DDeGonge/MiniBot/README.md

# MiniBot
Super cheap super tiny bots for....well I don't know yet
