DDeGonge/MiniBot/pcbs/MiniBot_MainBoard/MiniBot.kicad_pcb

## KiCad design pcbs/MiniBot_MainBoard/MiniBot.kicad_pcb (2026-08-21)

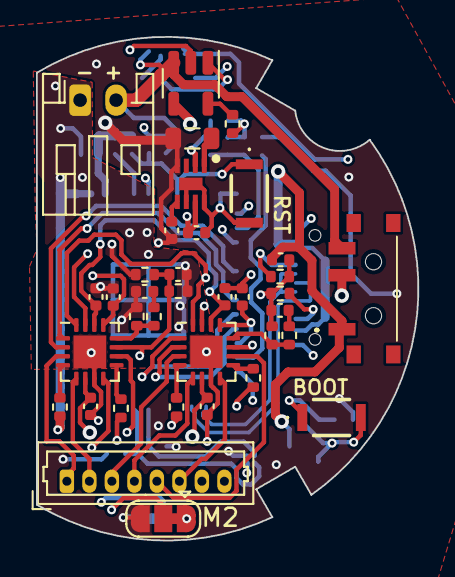
[picture p1: board pcbs/MiniBot_MainBoard/MiniBot.kicad_pcb from above]

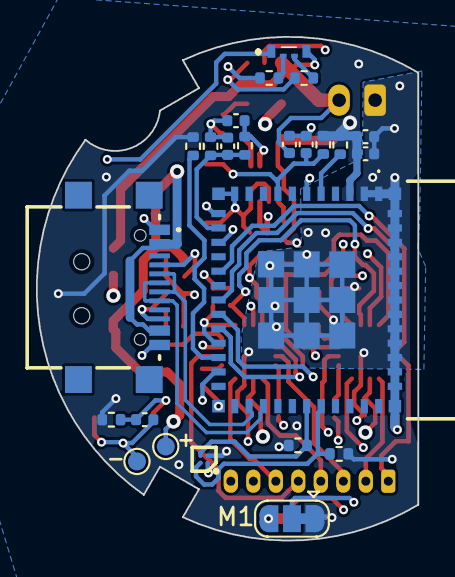
[picture p2: board pcbs/MiniBot_MainBoard/MiniBot.kicad_pcb from below]

Board: 4 copper layers, 21.2 x 28.0 mm, 60 parts (24 on the bottom side), 48 nets.

Parts:
C1, C8, C10: 4.7uF; C_0402_1005Metric
C2, C4, C5, C6, C9, C15, C16, C19, C20, C23: 0.1uF; C_0402_1005Metric
C3: 1uF; C_0402_1005Metric
C7: 560pF; C_0402_1005Metric
C17, C21: 10uF; C_0402_1005Metric
C18, C22: 22nF; C_0402_1005Metric
IC1: MMC5633NJL; BGA4C40P2X2_85X85X60
IC2: MIC23050-SYML-TR; SON50P200X200X90-9N-D
J1: Conn_01x08; Molex_PicoBlade_53047-0810_1x08_P1.25mm_Vertical
J2: Conn_01x02; JST_PH_S2B-PH-K_1x02_P2.00mm_Horizontal
J3: GSB1C41110SSHR
JP1, JP2: Jumper_3_Bridged12; SolderJumper-3_P1.3mm_Bridged12_RoundedPad1.0x1.5mm
L1: L; L_0805_2012Metric
LED1: EASV2010RWA0
R1, R2, R14, R15: 5.1k; R_0402_1005Metric
R3, R4, R5, R6, R9, R12: 10k; R_0402_1005Metric
R7, R10, R11: 390k; R_0402_1005Metric
R8: 12.4k; R_0402_1005Metric
R13, R16, R20: 1k; R_0402_1005Metric
R18, R19, R22, R23: 1; R_0402_1005Metric
R24, R25: 47k; R_0402_1005Metric
S1: PCM12SMTR
S2, S3: EVP-AWBD4A; EVPAWBD4A
TP1, TP2: TestPoint; TestPoint_Pad_D1.0mm
U1: ESP32-C3-MINI-1-H4X; ESP32C3MINI1H4X
U3: MCP73832-2-OT; SOT-23-5
U4, U5: STSPIN220; VQFN-16-1EP_3x3mm_P0.5mm_EP1.8x1.8mm

Connections:
+3V3: C1.2, C2.1, C7.1, IC1.B1 (VDD), IC2.4 (SNS), JP1.3 (B), JP2.1 (A), L1.1, R1.1, R2.1, R3.1, R5.1, R6.1, R7.1, R9.1, U1.3 (3V3)
+5V: C9.1, J3.A4 (VBUS_1), J3.A9 (VBUS_2), S1.1 (NC), TP2.1, U3.4 (V_{DD})
+BATT: C10.1, J2.2, LED1.4 (R6+), S1.3 (NO), U3.3 (V_{BAT})
/CC1: J3.A5 (CC1), R14.1
/CC2: J3.B5 (CC2), R15.1
/CFF: C7.2, IC2.5 (CFF)
/GPIO2: R6.2, U1.5 (IO2)
/GPIO8: R5.2, U1.22 (IO8)
/GPIO9: C5.1, R9.2, S3.A1 (NO), U1.23 (IO9)
/LED_R: LED1.3 (R6-), R13.1
/LED_W: LED1.1 (T1+), U1.12 (IO0)
/M0_A1: J1.1, U4.3 (OUTA1)
/M0_A2: J1.2, U4.5 (OUTA2)
/M0_B1: J1.8, U4.10 (OUTB1)
/M0_B2: J1.7, U4.8 (OUTB2)
/M0_DIR: U1.18 (IO4), U4.1 (DIR)
/M0_STEP: U1.16 (IO10), U4.2 (STCK)
/M1_A1: J1.3, U5.3 (OUTA1)
/M1_A2: J1.4, U5.5 (OUTA2)
/M1_B1: J1.5, U5.10 (OUTB1)
/M1_B2: J1.6, U5.8 (OUTB2)
/M1_DIR: U1.19 (IO5), U5.1 (DIR)
/M1_STEP: U1.20 (IO6), U5.2 (STCK)
/MODE1: JP2.2 (C), U4.16 (MODE1), U5.16 (MODE1)
/MODE2: JP1.2 (C), U4.15 (MODE2), U5.15 (MODE2)
/M_EN: C15.1, C19.1, U1.21 (IO7), U4.13 (EN/FLT), U5.13 (EN/FLT)
/M_RST: C16.1, C20.1, U1.6 (IO3), U4.14 (STBY/RESET), U5.14 (STBY/RESET)
/RST: C3.1, R3.2, S2.A1 (NO), U1.8 (EN)
/SCL: IC1.A2 (SCL), R1.2, U1.31 (TXD0)
/SDA: IC1.B2 (SDA), R2.2, U1.30 (RXD0)
/USB+: J3.A6 (DP1), J3.B6 (DP2), U1.27 (IO19)
/USB-: J3.A7 (DN1), J3.B7 (DN2), U1.26 (IO18)
/VREF: C4.1, R7.2, R8.1, U4.11 (REF), U5.11 (REF)
/VSENSE: C6.1, R10.2, R11.1, U1.13 (IO1)
GND: C1.1, C2.2, C3.2, C4.2, C5.2, C6.2, C8.2, C9.2, C10.2, C15.2, C16.2, C17.2, C18.2, C19.2, C20.2, C21.2, C22.2, C23.2, IC1.A1 (VSA), IC2.6 (AGND), IC2.8 (PGND), IC2.9 (EP), J2.1, J3.A1 (GND_1), J3.A12 (GND_2), JP1.1 (A), JP2.3 (B), R4.2, R8.2, R11.2, R12.2, R14.2, R15.2, R18.2, R19.2, R22.2, R23.2, R24.2, R25.2, S2.A2 (COM), S3.A2 (COM), TP1.1, U1.1 (GND_1), U1.2 (GND_2), U1.11 (GND_3), U1.14 (GND_4), U1.36 (GND_5), U1.37 (GND_6), U1.38 (GND_7), U1.39 (GND_8), U1.40 (GND_9), U1.41 (GND_10), U1.42 (GND_11), U1.43 (GND_12), U1.44 (GND_13), U1.45 (GND_14), U1.46 (GND_15), U1.47 (GND_16), U1.48 (GND_17), U1.49 (GND_18), U1.50 (GND_19), U1.51 (GND_20), U1.52 (GND_21), U1.53 (GND_22), U1.54 (GND_23), U1.55 (GND_24), U1.56 (GND_25), U1.57 (GND_26), U1.58 (GND_27), U1.59 (GND_28), U1.60 (GND_29), U1.61 (GND_30), U3.2 (V_{SS}), U4.7 (GND), U4.17 (EPAD), U5.7 (GND), U5.17 (EPAD)
unnamed: C18.1, R16.2
unnamed: C22.1, R20.2
unnamed: IC2.1 (SW), L1.2
unnamed: LED1.2 (T1-), R4.1
unnamed: R12.1, U3.5 (PROG)
unnamed: R13.2, U3.1 (STAT)
unnamed: R19.1, U4.4 (SENSEA)
unnamed: R18.1, U4.9 (SENSEB)
unnamed: R16.1, R24.1, U4.12 (TOFF)
unnamed: R23.1, U5.4 (SENSEA)
unnamed: R22.1, U5.9 (SENSEB)
unnamed: R20.1, R25.1, U5.12 (TOFF)
VDC: C8.1, C17.1, C21.1, C23.1, IC2.2 (EN), IC2.7 (VIN), R10.1, S1.2 (COM), U4.6 (VS), U5.6 (VS)
