DDeGonge/MiniBot/pcbs/Charge_Case/Charge_Case.kicad_pcb

## KiCad design pcbs/Charge_Case/Charge_Case.kicad_pcb (2026-07-29)

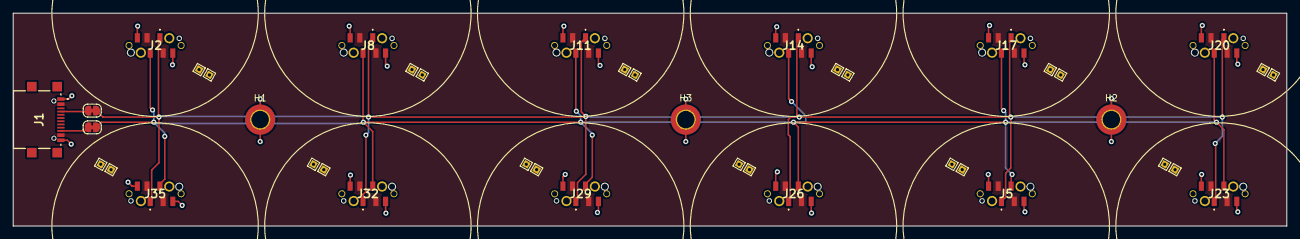
[picture p3: board Charge_Case.kicad_pcb from above]

Board: 2 copper layers, 197.5 x 33.0 mm, 42 parts (0 on the bottom side), 8 nets.

Parts:
H1, H2, H3: MountingHole_Pad; MountingHole_2.7mm_M2.5_DIN965_Pad_TopOnly
J1: GSB1C41110SSHR
J2, J5, J8, J11, J14, J17, J20, J23, J26, J29, J32, J35: USB4180-03-0120-C; USB4180030120C
J3, J4, J6, J7, J9, J10, J12, J13, J15, J16, J18, J19, J21, J22, J24, J25, J27, J28, J30, J31, J33, J34, J36, J37: Conn_01x01; TestPoint_THTPad_1.0x1.0mm_Drill0.5mm
JP1, JP2: Jumper_2_Bridged; SolderJumper-2_P1.3mm_Bridged_RoundedPad1.0x1.5mm

Connections:
+5V: J1.A4 (VBUS_1), J1.A9 (VBUS_2), J2.A9 (VBUS_1), J2.B9 (VBUS_2), J3.1, J5.A9 (VBUS_1), J5.B9 (VBUS_2), J6.1, J8.A9 (VBUS_1), J8.B9 (VBUS_2), J9.1, J11.A9 (VBUS_1), J11.B9 (VBUS_2), J12.1, J14.A9 (VBUS_1), J14.B9 (VBUS_2), J15.1, J17.A9 (VBUS_1), J17.B9 (VBUS_2), J18.1, J20.A9 (VBUS_1), J20.B9 (VBUS_2), J21.1, J23.A9 (VBUS_1), J23.B9 (VBUS_2), J24.1, J26.A9 (VBUS_1), J26.B9 (VBUS_2), J27.1, J29.A9 (VBUS_1), J29.B9 (VBUS_2), J30.1, J32.A9 (VBUS_1), J32.B9 (VBUS_2), J33.1, J35.A9 (VBUS_1), J35.B9 (VBUS_2), J36.1
/CC1: J2.A5 (CC1), J5.A5 (CC1), J8.A5 (CC1), J11.A5 (CC1), J14.A5 (CC1), J17.A5 (CC1), J20.A5 (CC1), J23.A5 (CC1), J26.A5 (CC1), J29.A5 (CC1), J32.A5 (CC1), J35.A5 (CC1), JP1.1 (A)
/CC1_SRC: J1.A5 (CC1), JP1.2 (B)
/CC2: J2.B5 (CC2), J5.B5 (CC2), J8.B5 (CC2), J11.B5 (CC2), J14.B5 (CC2), J17.B5 (CC2), J20.B5 (CC2), J23.B5 (CC2), J26.B5 (CC2), J29.B5 (CC2), J32.B5 (CC2), J35.B5 (CC2), JP2.1 (A)
/CC2_SRC: J1.B5 (CC2), JP2.2 (B)
GND: H1.1, H2.1, H3.1, J1.A1 (GND_1), J1.A12 (GND_2), J2.A12 (GND_1), J2.B12 (GND_2), J4.1, J5.A12 (GND_1), J5.B12 (GND_2), J7.1, J8.A12 (GND_1), J8.B12 (GND_2), J10.1, J11.A12 (GND_1), J11.B12 (GND_2), J13.1, J14.A12 (GND_1), J14.B12 (GND_2), J16.1, J17.A12 (GND_1), J17.B12 (GND_2), J19.1, J20.A12 (GND_1), J20.B12 (GND_2), J22.1, J23.A12 (GND_1), J23.B12 (GND_2), J25.1, J26.A12 (GND_1), J26.B12 (GND_2), J28.1, J29.A12 (GND_1), J29.B12 (GND_2), J31.1, J32.A12 (GND_1), J32.B12 (GND_2), J34.1, J35.A12 (GND_1), J35.B12 (GND_2), J37.1
unnamed: J1.A6 (DP1), J1.A7 (DN1)
unnamed: J1.B6 (DP2), J1.B7 (DN2)
