DDeGonge/MiniBot/pcb/MiniBot.kicad_pcb

## KiCad design pcb/MiniBot.kicad_pcb (2025-02-13)

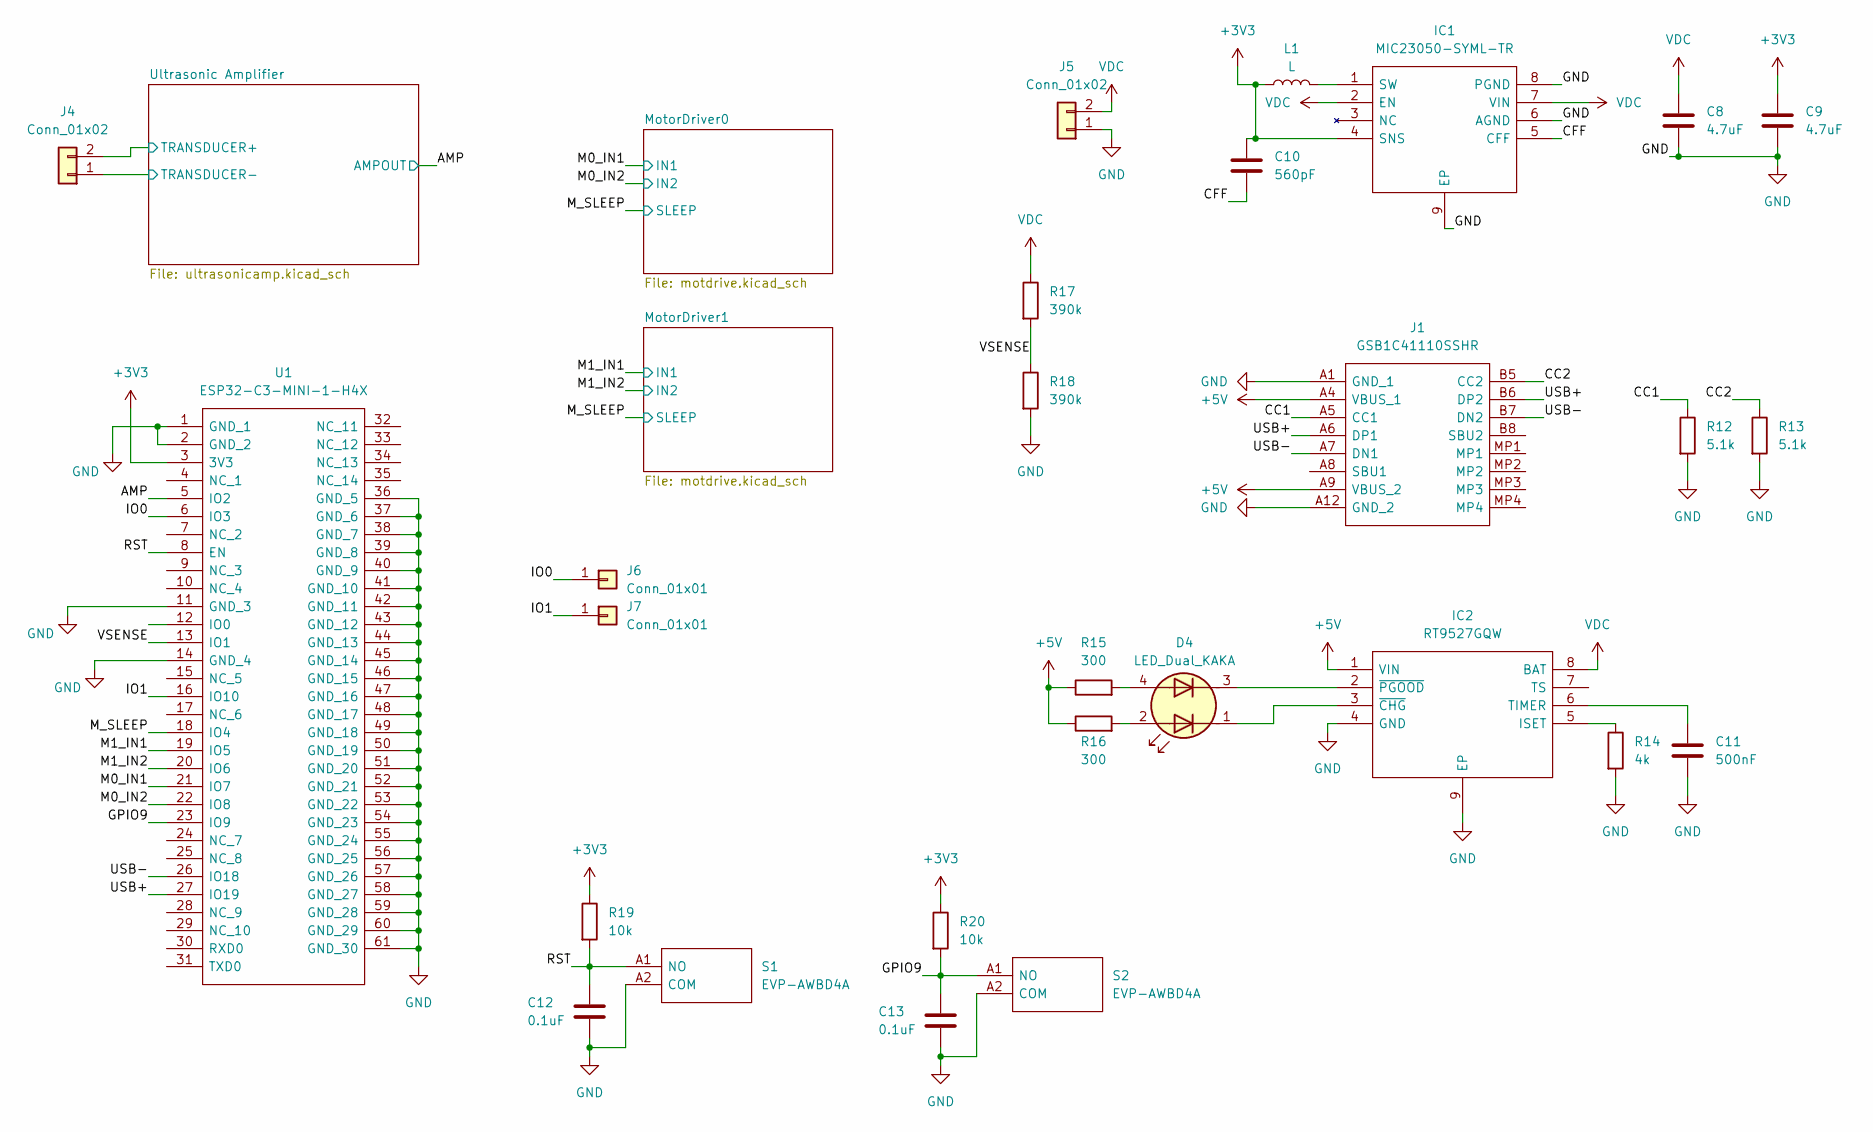
[picture p4: schematic MiniBot.kicad_sch]

Parts:
C8, C9: 4.7uF; C_0402_1005Metric
C10: 560pF; C_0402_1005Metric
C11: 500nF; C_0402_1005Metric
C12, C13: 0.1uF; C_0402_1005Metric
D4: LED_Dual_KAKA; SB0603WC01-RG
IC1: MIC23050-SYML-TR; SON50P200X200X90-9N-D; Mouser Part Number 998-MIC23050-SYMLTR
IC2: RT9527GQW; SON50P200X200X80-9N; Mouser Part Number 835-RT9527GQW
J1: GSB1C41110SSHR; Manufacturer_Part_Number GSB1C41110SSHR
J4: Conn_01x02; Transducer
J5: Conn_01x02; JST_PH_S2B-PH-K_1x02_P2.00mm_Horizontal
J6, J7: Conn_01x01; TestPoint_Pad_D1.0mm
L1: L; L_0805_2012Metric
R12, R13: 5.1k; R_0402_1005Metric
R14: 4k; R_0402_1005Metric
R15, R16: 300; R_0402_1005Metric
R17, R18: 390k; R_0402_1005Metric
R19, R20: 10k; R_0402_1005Metric
S1, S2: EVP-AWBD4A; EVPAWBD4A; Mouser Part Number 667-EVP-AWBD4A
U1: ESP32-C3-MINI-1-H4X; ESP32C3MINI1H4X; Mouser Part Number 356-ESP32C3MINI1H4X

Connections:
+3V3: C9.1, C10.1, IC1.4 (SNS), L1.1, R19.1, R20.1, U1.3 (3V3); also elsewhere on the board
+5V: IC2.1 (VIN), J1.A4 (VBUS_1), J1.A9 (VBUS_2), R15.1, R16.1
/AMP: U1.5 (IO2); also elsewhere on the board
/CC1: J1.A5 (CC1), R12.1
/CC2: J1.B5 (CC2), R13.1
/CFF: C10.2, IC1.5 (CFF)
/GPIO9: C13.1, R20.2, S2.A1 (NO), U1.23 (IO9)
/IO0: J6.1, U1.6 (IO3)
/IO1: J7.1, U1.16 (IO10)
/M0_IN1: U1.21 (IO7); also elsewhere on the board
/M0_IN2: U1.22 (IO8); also elsewhere on the board
/M1_IN1: U1.19 (IO5); also elsewhere on the board
/M1_IN2: U1.20 (IO6); also elsewhere on the board
/M_SLEEP: U1.18 (IO4); also elsewhere on the board
/RST: C12.1, R19.2, S1.A1 (NO), U1.8 (EN)
/USB+: J1.A6 (DP1), J1.B6 (DP2), U1.27 (IO19)
/USB-: J1.A7 (DN1), J1.B7 (DN2), U1.26 (IO18)
/Ultrasonic Amplifier/IN1+: J4.2; also elsewhere on the board
/VSENSE: R17.2, R18.1, U1.13 (IO1)
GND: C8.2, C9.2, C11.2, C12.2, C13.2, IC1.6 (AGND), IC1.8 (PGND), IC1.9 (EP), IC2.4 (GND), IC2.9 (EP), J1.A1 (GND_1), J1.A12 (GND_2), J4.1, J5.1, R12.2, R13.2, R14.2, R18.2, S1.A2 (COM), S2.A2 (COM), U1.1 (GND_1), U1.2 (GND_2), U1.11 (GND_3), U1.14 (GND_4), U1.36 (GND_5), U1.37 (GND_6), U1.38 (GND_7), U1.39 (GND_8), U1.40 (GND_9), U1.41 (GND_10), U1.42 (GND_11), U1.43 (GND_12), U1.44 (GND_13), U1.45 (GND_14), U1.46 (GND_15), U1.47 (GND_16), U1.48 (GND_17), U1.49 (GND_18), U1.50 (GND_19), U1.51 (GND_20), U1.52 (GND_21), U1.53 (GND_22), U1.54 (GND_23), U1.55 (GND_24), U1.56 (GND_25), U1.57 (GND_26), U1.58 (GND_27), U1.59 (GND_28), U1.60 (GND_29), U1.61 (GND_30); also elsewhere on the board
unnamed: D4.1 (A1), IC2.3 (~CHG)
unnamed: D4.3 (A2), IC2.2 (~PGOOD)
unnamed: D4.2 (K1), R16.2
unnamed: D4.4 (K2), R15.2
unnamed: IC1.1 (SW), L1.2
unnamed: IC2.5 (ISET), R14.1
unnamed: C11.1, IC2.6 (TIMER)
VDC: C8.1, IC1.2 (EN), IC1.7 (VIN), IC2.8 (BAT), J5.2, R17.1; also elsewhere on the board

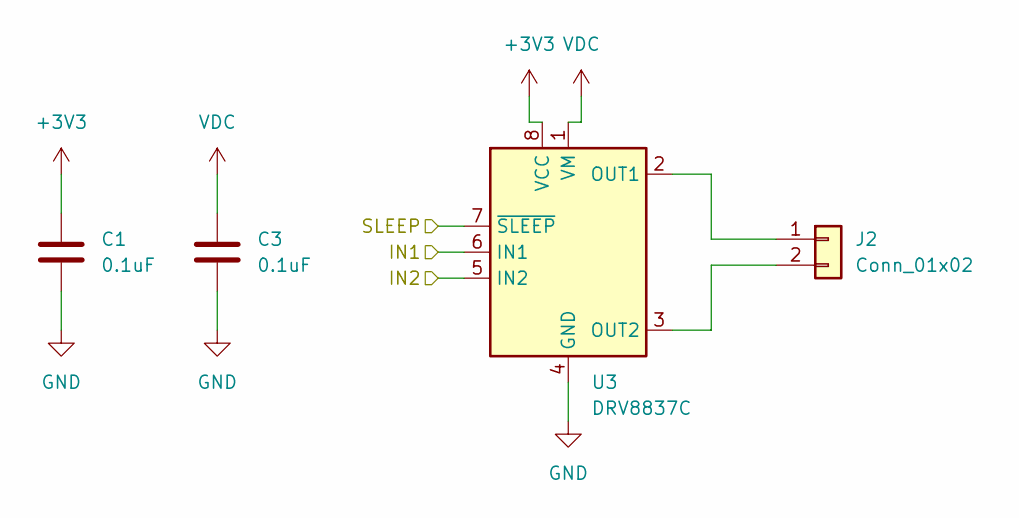
[picture p5: schematic motdrive.kicad_sch]

Parts:
C1, C3: 0.1uF; C_0402_1005Metric
J2: Conn_01x02; PinHeader_1x02_P1.27mm_Vertical
U3: DRV8837C; WSON-8-1EP_2x2mm_P0.5mm_EP0.9x1.6mm

Connections:
+3V3: C1.1, U3.8 (VCC); also elsewhere on the board
/M0_IN1: U3.6 (IN1); also elsewhere on the board
/M0_IN2: U3.5 (IN2); also elsewhere on the board
/M_SLEEP: U3.7 (~SLEEP); also elsewhere on the board
GND: C1.2, C3.2, U3.4 (GND), U3.9 (GND); also elsewhere on the board
unnamed: J2.1, U3.2 (OUT1)
unnamed: J2.2, U3.3 (OUT2)
VDC: C3.1, U3.1 (VM); also elsewhere on the board

Parts of its further copies:
C2, C4: 0.1uF; C_0402_1005Metric
J3: Conn_01x02; PinHeader_1x02_P1.27mm_Vertical
U4: DRV8837C; WSON-8-1EP_2x2mm_P0.5mm_EP0.9x1.6mm

Connections of its further copies:
+3V3: C2.1, U4.8 (VCC); also elsewhere on the board
/M1_IN1: U4.6 (IN1); also elsewhere on the board
/M1_IN2: U4.5 (IN2); also elsewhere on the board
/M_SLEEP: U4.7 (~SLEEP); also elsewhere on the board
GND: C2.2, C4.2, U4.4 (GND), U4.9 (GND); also elsewhere on the board
unnamed: J3.1, U4.2 (OUT1)
unnamed: J3.2, U4.3 (OUT2)
VDC: C4.1, U4.1 (VM); also elsewhere on the board

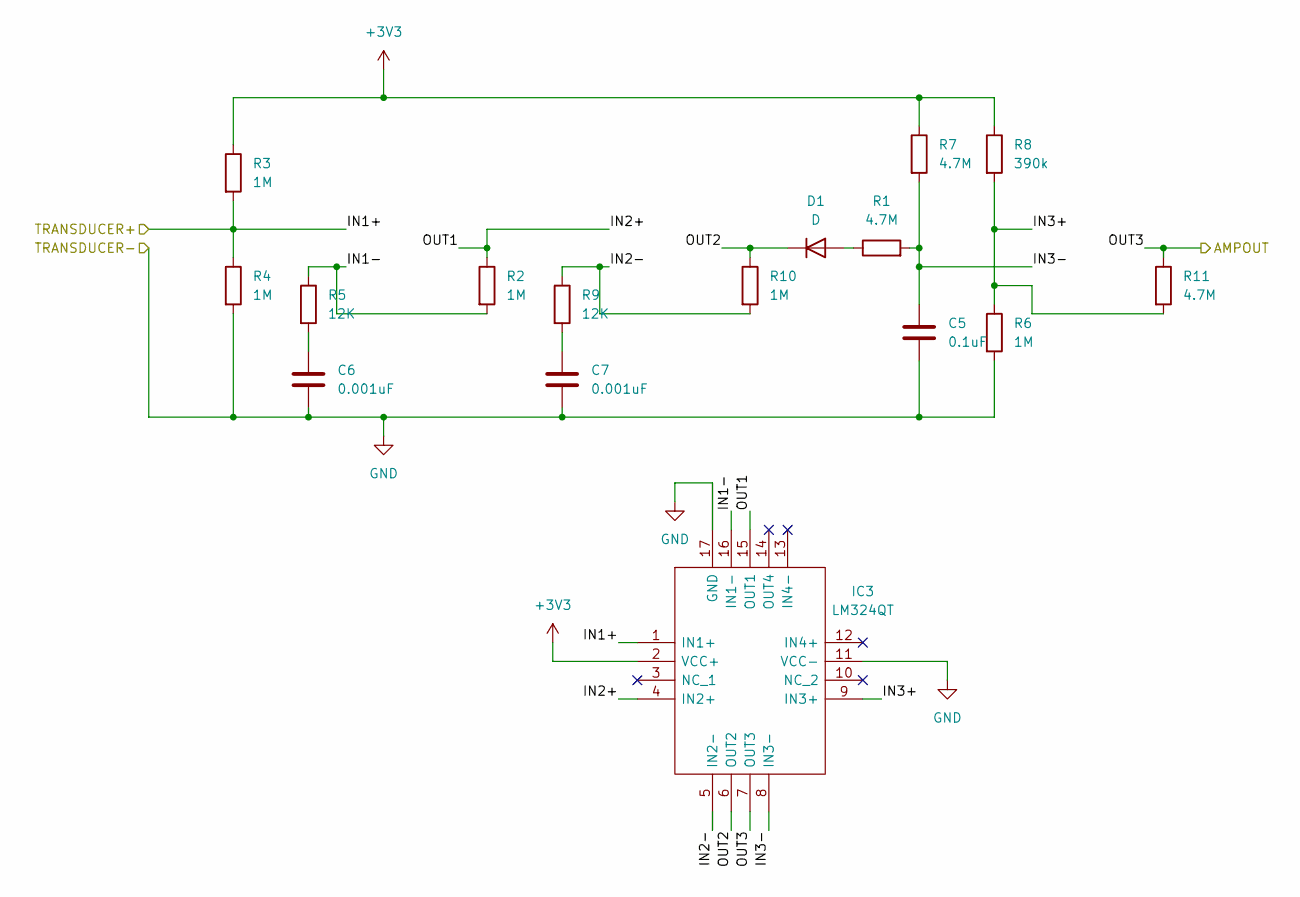
[picture p6: schematic ultrasonicamp.kicad_sch]

Parts:
C5: 0.1uF; C_0402_1005Metric
C6, C7: 0.001uF; C_0402_1005Metric
D1: D; D_0402_1005Metric
IC3: LM324QT; QFN50P300X300X100-17N; Mouser Part Number 511-LM324QT
R1, R7, R11: 4.7M; R_0402_1005Metric
R2, R3, R4, R6, R10: 1M; R_0402_1005Metric
R5, R9: 12K; R_0402_1005Metric
R8: 390k; R_0402_1005Metric

Connections:
+3V3: IC3.2 (VCC+), R3.1, R7.1, R8.1; also elsewhere on the board
/AMP: IC3.7 (OUT3), R11.1; also elsewhere on the board
/Ultrasonic Amplifier/IN1+: IC3.1 (IN1+), R3.2, R4.1; also elsewhere on the board
/Ultrasonic Amplifier/IN1-: IC3.16 (IN1-), R2.2, R5.1
/Ultrasonic Amplifier/IN2+: IC3.4 (IN2+), IC3.15 (OUT1), R2.1
/Ultrasonic Amplifier/IN2-: IC3.5 (IN2-), R9.1, R10.2
/Ultrasonic Amplifier/IN3+: IC3.9 (IN3+), R6.1, R8.2, R11.2
/Ultrasonic Amplifier/IN3-: C5.1, IC3.8 (IN3-), R1.2, R7.2
/Ultrasonic Amplifier/OUT2: D1.1 (K), IC3.6 (OUT2), R10.1
GND: C5.2, C6.2, C7.2, IC3.11 (VCC-), IC3.17 (GND), R4.2, R6.2; also elsewhere on the board
unnamed: C6.1, R5.2
unnamed: C7.1, R9.2
unnamed: D1.2 (A), R1.1

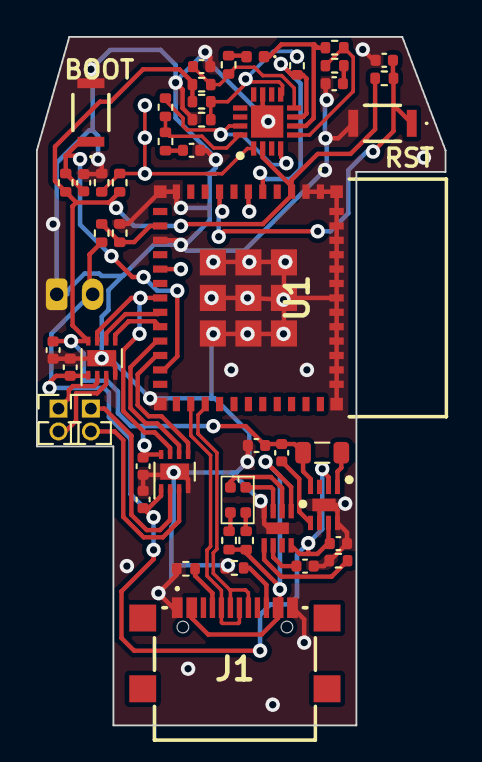
[picture p7: board pcb/MiniBot.kicad_pcb from above]

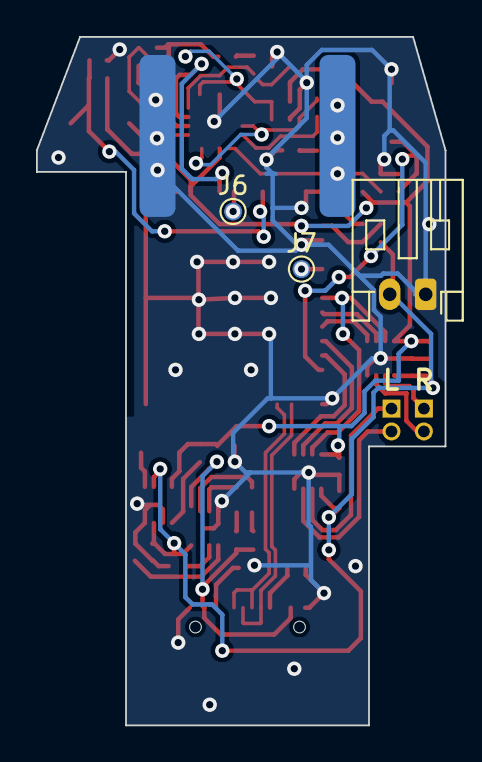
[picture p8: board pcb/MiniBot.kicad_pcb from below]

Board: 2 copper layers, 22.7 x 38.2 mm, 51 parts (4 on the bottom side), 41 nets.
