DDeGonge/MiniBot/pcbs/Server_Motherboard/Server_Motherboard.kicad_pcb

## KiCad design pcbs/Server_Motherboard/Server_Motherboard.kicad_pcb (2026-07-29)

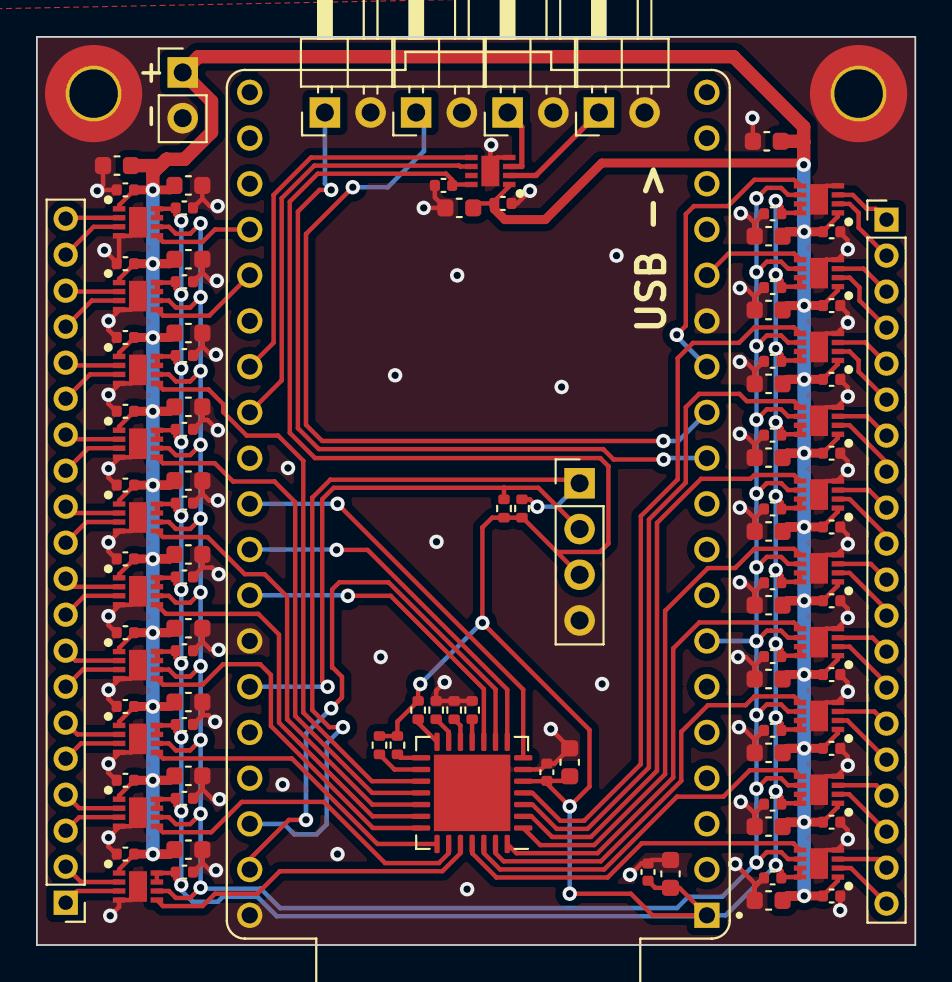
[picture p9: board Server_Motherboard.kicad_pcb from above]

Board: 2 copper layers, 48.8 x 50.4 mm, 110 parts (0 on the bottom side), 82 nets.

Parts:
C1, C3, C5, C7, C9, C11, C13, C15, C17, C19, C21, C23, C25, C27, C29, C31, C33, C35, C37, C39, C41, C64, C65, C66, C68: 10uF; C_0603_1608Metric
C2, C4, C6, C8, C10, C12, C14, C16, C18, C20, C22, C24, C26, C28, C30, C32, C34, C36, C38, C40, C42, C43, C44, C45, C46, C47, C48, C49, C50, C51, C52, C53, C54, C55, C56, C57, C58, C59, C60, C61, C62, C63, C67, C69: 0.1uF; C_0402_1005Metric
H1, H2: MountingHole_Pad; MountingHole_2.7mm_M2.5_Pad_TopBottom
IC1, IC21, IC22, IC23, IC24, IC25, IC26, IC27, IC28, IC29, IC30, IC31, IC32, IC33, IC34, IC35, IC36, IC37, IC38, IC39, IC40: DRV8210DSGR; SON50P200X200X80-9N
J1, J2: Conn_01x20; PinHeader_1x20_P2.00mm_Vertical
J3: Conn_01x02; PinHeader_1x02_P2.54mm_Vertical
J4: Conn_01x04; PinHeader_1x04_P2.54mm_Vertical
J5, J6, J7, J8: Conn_01x02; PinHeader_1x02_P2.54mm_Horizontal
R1, R2, R3, R4, R5, R6, R7, R8: 10k; R_0402_1005Metric
U1: ESP32-DEVKITC-32E; MODULE_ESP32-DEVKITC-32E
U2: MCP23S17_ML; QFN-28-1EP_6x6mm_P0.65mm_EP4.25x4.25mm

Connections:
+3V3: C2.1, C43.1, C44.1, C45.1, C46.1, C47.1, C48.1, C49.1, C50.1, C51.1, C52.1, C53.1, C54.1, C55.1, C56.1, C57.1, C58.1, C59.1, C60.1, C61.1, C62.1, C63.1, C64.1, C65.1, C67.1, IC1.8 (VCC), IC21.7 (MODE), IC21.8 (VCC), IC22.7 (MODE), IC22.8 (VCC), IC23.7 (MODE), IC23.8 (VCC), IC24.7 (MODE), IC24.8 (VCC), IC25.7 (MODE), IC25.8 (VCC), IC26.7 (MODE), IC26.8 (VCC), IC27.7 (MODE), IC27.8 (VCC), IC28.7 (MODE), IC28.8 (VCC), IC29.7 (MODE), IC29.8 (VCC), IC30.7 (MODE), IC30.8 (VCC), IC31.7 (MODE), IC31.8 (VCC), IC32.7 (MODE), IC32.8 (VCC), IC33.7 (MODE), IC33.8 (VCC), IC34.7 (MODE), IC34.8 (VCC), IC35.7 (MODE), IC35.8 (VCC), IC36.7 (MODE), IC36.8 (VCC), IC37.7 (MODE), IC37.8 (VCC), IC38.7 (MODE), IC38.8 (VCC), IC39.7 (MODE), IC39.8 (VCC), IC40.7 (MODE), IC40.8 (VCC), J4.3, R1.1, R2.1, R6.1, R7.1, R8.1, U1.J2_1 (3V3), U2.5 (VDD)
/A0: R3.1, U2.11 (A0)
/A1: R4.1, U2.12 (A1)
/A2: R5.1, U2.13 (A2)
/COIL0_A: IC21.2 (OUT1), J1.20
/COIL0_B: IC21.3 (OUT2), J1.19
/COIL1_A: IC22.2 (OUT1), J1.18
/COIL1_B: IC22.3 (OUT2), J1.17
/COIL2_A: IC23.2 (OUT1), J1.16
/COIL2_B: IC23.3 (OUT2), J1.15
/COIL3_A: IC24.2 (OUT1), J1.14
/COIL3_B: IC24.3 (OUT2), J1.13
/COIL4_A: IC25.2 (OUT1), J1.12
/COIL4_B: IC25.3 (OUT2), J1.11
/COIL5_A: IC26.2 (OUT1), J1.10
/COIL5_B: IC26.3 (OUT2), J1.9
/COIL6_A: IC27.2 (OUT1), J1.8
/COIL6_B: IC27.3 (OUT2), J1.7
/COIL7_A: IC28.2 (OUT1), J1.6
/COIL7_B: IC28.3 (OUT2), J1.5
/COIL8_A: IC29.2 (OUT1), J1.4
/COIL8_B: IC29.3 (OUT2), J1.3
/COIL9_A: IC30.2 (OUT1), J1.2
/COIL9_B: IC30.3 (OUT2), J1.1
/COIL10_A: IC31.2 (OUT1), J2.20
/COIL10_B: IC31.3 (OUT2), J2.19
/COIL11_A: IC32.2 (OUT1), J2.18
/COIL11_B: IC32.3 (OUT2), J2.17
/COIL12_A: IC33.2 (OUT1), J2.16
/COIL12_B: IC33.3 (OUT2), J2.15
/COIL13_A: IC34.2 (OUT1), J2.14
/COIL13_B: IC34.3 (OUT2), J2.13
/COIL14_A: IC35.2 (OUT1), J2.12
/COIL14_B: IC35.3 (OUT2), J2.11
/COIL15_A: IC36.2 (OUT1), J2.10
/COIL15_B: IC36.3 (OUT2), J2.9
/COIL16_A: IC37.2 (OUT1), J2.8
/COIL16_B: IC37.3 (OUT2), J2.7
/COIL17_A: IC38.2 (OUT1), J2.6
/COIL17_B: IC38.3 (OUT2), J2.5
/COIL18_A: IC39.2 (OUT1), J2.4
/COIL18_B: IC39.3 (OUT2), J2.3
/COIL19_A: IC40.2 (OUT1), J2.2
/COIL19_B: IC40.3 (OUT2), J2.1
/COIL_DIR: IC21.6 (IN1/PH), IC22.6 (IN1/PH), IC23.6 (IN1/PH), IC24.6 (IN1/PH), IC25.6 (IN1/PH), IC26.6 (IN1/PH), IC27.6 (IN1/PH), IC28.6 (IN1/PH), IC29.6 (IN1/PH), IC30.6 (IN1/PH), IC31.6 (IN1/PH), IC32.6 (IN1/PH), IC33.6 (IN1/PH), IC34.6 (IN1/PH), IC35.6 (IN1/PH), IC36.6 (IN1/PH), IC37.6 (IN1/PH), IC38.6 (IN1/PH), IC39.6 (IN1/PH), IC40.6 (IN1/PH), U1.J2_7 (IO32)
/C_EN_0: IC21.5 (IN2/EN), U1.J3_16 (IO15)
/C_EN_1: IC22.5 (IN2/EN), U1.J3_15 (IO2)
/C_EN_2: IC23.5 (IN2/EN), U2.17 (GPA0)
/C_EN_3: IC24.5 (IN2/EN), U2.18 (GPA1)
/C_EN_4: IC25.5 (IN2/EN), U2.19 (GPA2)
/C_EN_5: IC26.5 (IN2/EN), U2.20 (GPA3)
/C_EN_6: IC27.5 (IN2/EN), U2.21 (GPA4)
/C_EN_7: IC28.5 (IN2/EN), U2.22 (GPA5)
/C_EN_8: IC29.5 (IN2/EN), U2.23 (GPA6)
/C_EN_9: IC30.5 (IN2/EN), U2.24 (GPA7)
/C_EN_10: IC31.5 (IN2/EN), U2.25 (GPB0)
/C_EN_11: IC32.5 (IN2/EN), U2.26 (GPB1)
/C_EN_12: IC33.5 (IN2/EN), U2.27 (GPB2)
/C_EN_13: IC34.5 (IN2/EN), U2.28 (GPB3)
/C_EN_14: IC35.5 (IN2/EN), U2.1 (GPB4)
/C_EN_15: IC36.5 (IN2/EN), U2.2 (GPB5)
/C_EN_16: IC37.5 (IN2/EN), U2.3 (GPB6)
/C_EN_17: IC38.5 (IN2/EN), U2.4 (GPB7)
/C_EN_18: IC39.5 (IN2/EN), U1.J2_15 (IO13)
/C_EN_19: IC40.5 (IN2/EN), U1.J2_13 (IO12)
/GPIO_CS: U1.J3_10 (IO5), U2.7 (~CS)
/INTA: R7.2, U2.16 (INTA)
/INTB: R8.2, U2.15 (INTB)
/MISO: U1.J3_8 (IO19), U2.10 (SO)
/MOSI: U1.J3_2 (IO23), U2.9 (SI)
/RESET: R6.2, U2.14 (~RESET)
/SCK: U1.J3_9 (IO18), U2.8 (SCK)
/SCL: J4.1, R1.2, U1.J3_3 (IO22)
/SDA: J4.2, R2.2, U1.J3_6 (IO21)
/SOL_0: IC1.3 (OUT2), J5.1
/SOL_1: IC1.2 (OUT1), J6.1
/SOL_EN_0: IC1.6 (IN1/PH), U1.J3_12 (IO16)
/SOL_EN_1: IC1.5 (IN2/EN), U1.J3_13 (IO4)
/SW1: J7.1, U1.J2_11 (IO27)
/SW2: J8.1, U1.J2_12 (IO14)
GND: C1.1, C2.2, C3.2, C4.2, C5.2, C6.2, C7.2, C8.2, C9.2, C10.2, C11.2, C12.2, C13.2, C14.2, C15.2, C16.2, C17.2, C18.2, C19.2, C20.2, C21.2, C22.2, C23.2, C24.2, C25.2, C26.2, C27.2, C28.2, C29.2, C30.2, C31.2, C32.2, C33.2, C34.2, C35.2, C36.2, C37.2, C38.2, C39.2, C40.2, C41.2, C42.2, C43.2, C44.2, C45.2, C46.2, C47.2, C48.2, C49.2, C50.2, C51.2, C52.2, C53.2, C54.2, C55.2, C56.2, C57.2, C58.2, C59.2, C60.2, C61.2, C62.2, C63.2, C64.2, C65.2, C66.2, C67.2, C68.2, C69.2, H1.1, H2.1, IC1.4 (GND), IC1.9 (EP), IC21.4 (GND), IC21.9 (EP), IC22.4 (GND), IC22.9 (EP), IC23.4 (GND), IC23.9 (EP), IC24.4 (GND), IC24.9 (EP), IC25.4 (GND), IC25.9 (EP), IC26.4 (GND), IC26.9 (EP), IC27.4 (GND), IC27.9 (EP), IC28.4 (GND), IC28.9 (EP), IC29.4 (GND), IC29.9 (EP), IC30.4 (GND), IC30.9 (EP), IC31.4 (GND), IC31.9 (EP), IC32.4 (GND), IC32.9 (EP), IC33.4 (GND), IC33.9 (EP), IC34.4 (GND), IC34.9 (EP), IC35.4 (GND), IC35.9 (EP), IC36.4 (GND), IC36.9 (EP), IC37.4 (GND), IC37.9 (EP), IC38.4 (GND), IC38.9 (EP), IC39.4 (GND), IC39.9 (EP), IC40.4 (GND), IC40.9 (EP), J3.2, J4.4, J5.2, J6.2, J7.2, J8.2, R3.2, R4.2, R5.2, U1.J2_14 (GND_J2_14), U1.J3_1 (GND_J3_1), U1.J3_7 (GND_J3_7), U2.6 (VSS), U2.29 (EP)
VDC: C1.2, C3.1, C4.1, C5.1, C6.1, C7.1, C8.1, C9.1, C10.1, C11.1, C12.1, C13.1, C14.1, C15.1, C16.1, C17.1, C18.1, C19.1, C20.1, C21.1, C22.1, C23.1, C24.1, C25.1, C26.1, C27.1, C28.1, C29.1, C30.1, C31.1, C32.1, C33.1, C34.1, C35.1, C36.1, C37.1, C38.1, C39.1, C40.1, C41.1, C42.1, C66.1, C68.1, C69.1, IC1.1 (VM), IC21.1 (VM), IC22.1 (VM), IC23.1 (VM), IC24.1 (VM), IC25.1 (VM), IC26.1 (VM), IC27.1 (VM), IC28.1 (VM), IC29.1 (VM), IC30.1 (VM), IC31.1 (VM), IC32.1 (VM), IC33.1 (VM), IC34.1 (VM), IC35.1 (VM), IC36.1 (VM), IC37.1 (VM), IC38.1 (VM), IC39.1 (VM), IC40.1 (VM), J3.1
