DDeGonge/MiniBot/firmware/MiniBot_Server/include/config.h

#ifndef CONFIG_H
#define CONFIG_H

#include <Arduino.h>

#define SERIAL_BAUD_RATE 921600

// System config flags
#define ENABLE_JOYSTICK_MODE false
#define ENABLE_WEB_GUI true
#define ENABLE_DEBUG_PRINTS false

// Random GPIO
#define STATUS_LED_WHITE_PIN 5
#define STATUS_LED_RED_PIN 4

// Timing parameters (milliseconds)
#define EMAG_FRAME_LEN_MS 100 // Total frame length
#define EMAG_COUNT 3          // Number of electromagnets in pattern
#define EMAG_FWD_ON_TIME_MS 7 // How long forward power is applied
#define EMAG_REV_ON_TIME_MS 7 // How long reverse power is applied

// PosSync burst configuration
#define POS_SYNC_INITIAL_DELAY_MS 5  // Delay before first sync pulse
#define POS_SYNC_BURST_COUNT 30      // Number of sync pulses in burst
#define POS_SYNC_BURST_INTERVAL_MS 3 // Interval between burst pulses

// Bots only listen for ESP-NOW commands during a short window each period,
// anchored to the PosSync epoch (nextFrameStartUs). ESPNowTask grabs elevated
// priority just before the window opens so its broadcast can't be preempted.
#define ESPNOW_TASK_PRIORITY 3 // Normal task priority (see main.cpp)
#define ESPNOW_TASK_WINDOW_PRIORITY                                            \
  5                             // Elevated priority held during the TX window
#define CMD_WINDOW_PERIOD_MS 40 // Period between bot RX windows
#define CMD_WINDOW_LEN_MS 4     // Duration of each bot RX window
#define CMD_WINDOW_PRIORITY_LEAD_MS                                            \
  1 // How long before the window to raise priority

// Shared GPIO pin for electromagnet direction
const uint8_t EMAG_DIR_PIN = 32;
const bool flip_emag_direction = true;

// Per-electromagnet enable pin numbers. If on IO expander, Port A is 0-7, B is
// 8-15
const uint8_t EMAG_EN_PINS[EMAG_COUNT] = {
    2, // EMAG 1: native GPIO 2
    0, // EMAG 2: expander pin 0
    1, // EMAG 3: expander pin 1
};

const bool EMAG_EN_ON_EXPANDER[EMAG_COUNT] = {
    false,
    true,
    true,
};

// ============= Joystick Configuration =============
#if ENABLE_JOYSTICK_MODE

#define JOYSTICK_TARGET_ID 0xFF // Broadcast ID for all robots

#define JOYSTICK_THROTTLE_PIN 1
#define JOYSTICK_STEERING_PIN 3

#define JOYSTICK_THROTTLE_CENTER 2190
#define JOYSTICK_STEERING_CENTER 2220

#define JOYSTICK_THROTTLE_INVERT -1
#define JOYSTICK_STEERING_INVERT 1

#define JOYSTICK_DEADZONE 50
#define JOYSTICK_MIN_TICK 50
#define JOYSTICK_MAX_TICK 4050

#define JOYSTICK_MAX_MOTOR_VELOCITY 127 // Max input value (int8)
#define JOYSTICK_STEERING_SCALE                                                \
  0.8 // sets upper limit for steering velocity as a fraction of max velocity

// Reduces steering authority with higher throttle
#define JOYSTICK_STEERING_INFLUENCE_FACTOR 0.70

#define JOYSTICK_UPDATE_INTERVAL_MS 100
#define JOYSTICK_WATCHDOG_INTERVAL_MS                                          \
  900 // Ensure the watchdog isn't tripped (1s timeout)

#endif // ENABLE_JOYSTICK_MODE

#if ENABLE_DEBUG_PRINTS
#define DEBUG_PRINTLN(x) Serial.println(x)
#define DEBUG_PRINTF(fmt, ...) Serial.printf(fmt, ##__VA_ARGS__)
#else
#define DEBUG_PRINTLN(x)
#define DEBUG_PRINTF(fmt, ...)
#endif

#endif // CONFIG_H
