DDeGonge/MiniBot/(commit log)

2025-02-13 initial pcb order
    [MiniBot.csv, MiniBot.kicad_pcb, MiniBot.kicad_sch, motdrive.kicad_sch, ultrasonicamp.kicad_sch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]
2026-06-22 Update roadmap
    Added section on power optimizations for battery life improvements, plus some other details
2026-07-29 update minibot fw, add pcb ordered packages
    [Charge_Case.kicad_pcb, Charge_Case.kicad_sch, MiniBot.csv, MiniBot.kicad_pcb, MiniBotV10.csv, MiniBot_V11_BOM.csv, MiniBotv09.csv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]
2026-08-21 fix stupid bad led symbol, general improvements to minibot fw
    [MiniBot.kicad_pcb, MiniBot.kicad_sch]
2026-09-04 changes to support new server pcb with io expander, and other fixes
    [ElectromagnetTask.cpp, ElectromagnetTask.h, config.h, led_status.cpp, main.cpp, mmc5633.cpp, mmc5633.h]
2026-09-04 reliability improvements to pos sensor but still some instabilities ugh
2026-09-07 bugfixes to sensor task and formatting
    [ESPNowTask.cpp, ElectromagnetTask.cpp, ElectromagnetTask.h, config.h, main.cpp, mmc5633.cpp, mmc5633.h]
